benboldtumd/flash-fns/Graphics/jra-pat.png

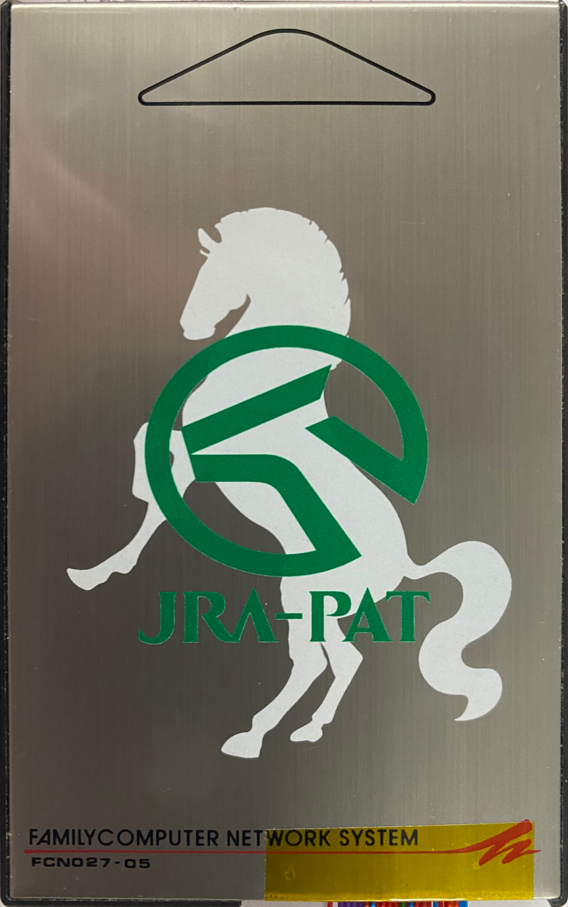
Graphics/jra-pat.png
