benboldtumd/flash-fns/(list of files, drawings)

Other design files:
Circuit Board/Projects/Flash-FNS-MMC3/flash_fns.dch
Circuit Board/Projects/Flash-FNS-MMC3/flash_fns.dip
