benboldtumd/flash-fns/(commit log)

2024-04-30 - Initial upload of files.
    [flash_fns.dch, flash_fns.dip]
2024-04-30 Fixed problem with the cutout in the unicorn's front legs.
2024-04-30 - Fixed spacing errors in PCB layout.
    [flash_fns.dip]
2024-05-04 Built and added Gerber files. These are the files that I am sending to PCBWay.
    [1 - Top.gbr, 2 - Bottom.gbr, BoardOutline.gbr, BottomAssembly.gbr, BottomDimension.gbr, BottomMask.gbr, BottomPaste.gbr, BottomSilk.gbr]
2024-05-04 - Added CPLD firmware based on Patroclus's work, recovered via wayback machine. Sources: https://forums.nesdev.org/viewtopic.php?t=10010 https://web.archive.org/web/20130927235439/http://www.consolas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
    [CPLD Pin Descriptions.xlsx]
2024-05-07 - PCBway rejected the initial upload due to missing Bottom Mask and board cutout. I added the board cutout, and I drew a line across the bottom mask. The new Gerber files were accepted this time.
    [flash_fns.dip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]
2024-05-07 - Added BOM.
    [BOM.csv]
2024-05-13 - Added MMC3-like mapper firmware for the CPLD.
    [BOM.csv]
2024-05-16 - Updated pitch of the FNS edge connector from 1.00mm (incorrect) to 0.04" (correct). - Updated BOM to reflect PMEG4010 that I am using. (This has slightly lower forward voltage drop.) - Updated M2 d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
    [BOM.csv, flash_fns.dip]
2024-05-16 - Swapped RAM /CE and /OE. The MMC1's +CS needs to control the RAM /CE. Zelda 1 operates with correct RAM function after this change, including working battery backup.
2024-05-23 - Bugfix: if a clear was sent instead of the final register bit, it was not properly clearing reg_bit_commit, and would have committed the register when writing the FIRST normal bit after this.
    [mmc1.vhdl]
2024-05-26 - Added CIC defeat VHDL code and corresponding trace on PCB.
    [flash_fns.dch, flash_fns.dip]
2024-06-03 - New PCBs were ordered from PCBWay with the gerber files in this revision. - Updated edge connector, correct 0.04” pitch now. - Added cut-link connection of the CIC key reset to the CPLD. (This need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
    [BOM.csv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]
2024-06-04 - Updating R5 and C20 to Krzysiobal's values that are intended for PRG-RAM /CS. These may still not be the correct values because we are dealing with 3.3V logic and schmitt triggers. But the values a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
    [BOM.csv]
2024-07-03 - Updated the BOM.
    [BOM.csv]
2024-07-03 - Inverted the CIC defeat signal for use with the 2N7002 level shifting rework.
    [cic_defeat.vhdl]
2024-07-03 - Adding another substitute part on the BOM for the 1.8V regulator.
    [BOM.csv]
